jjiang193/salinityspoon/docs/dashboard-out-of-range.png

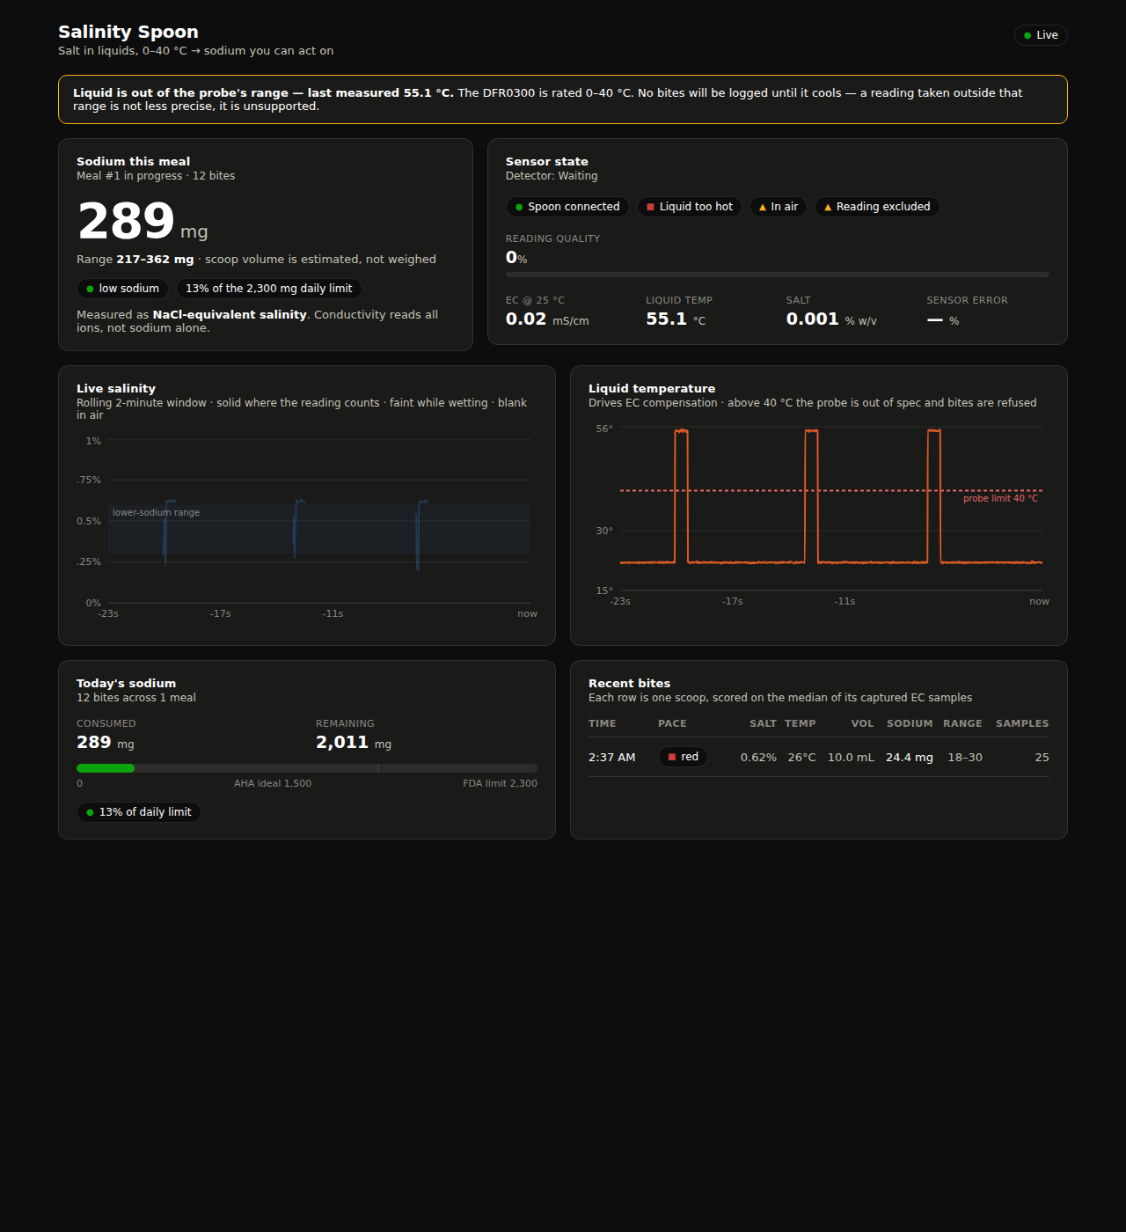
docs/dashboard-out-of-range.png
