jjiang193/salinityspoon/docs/dashboard.png

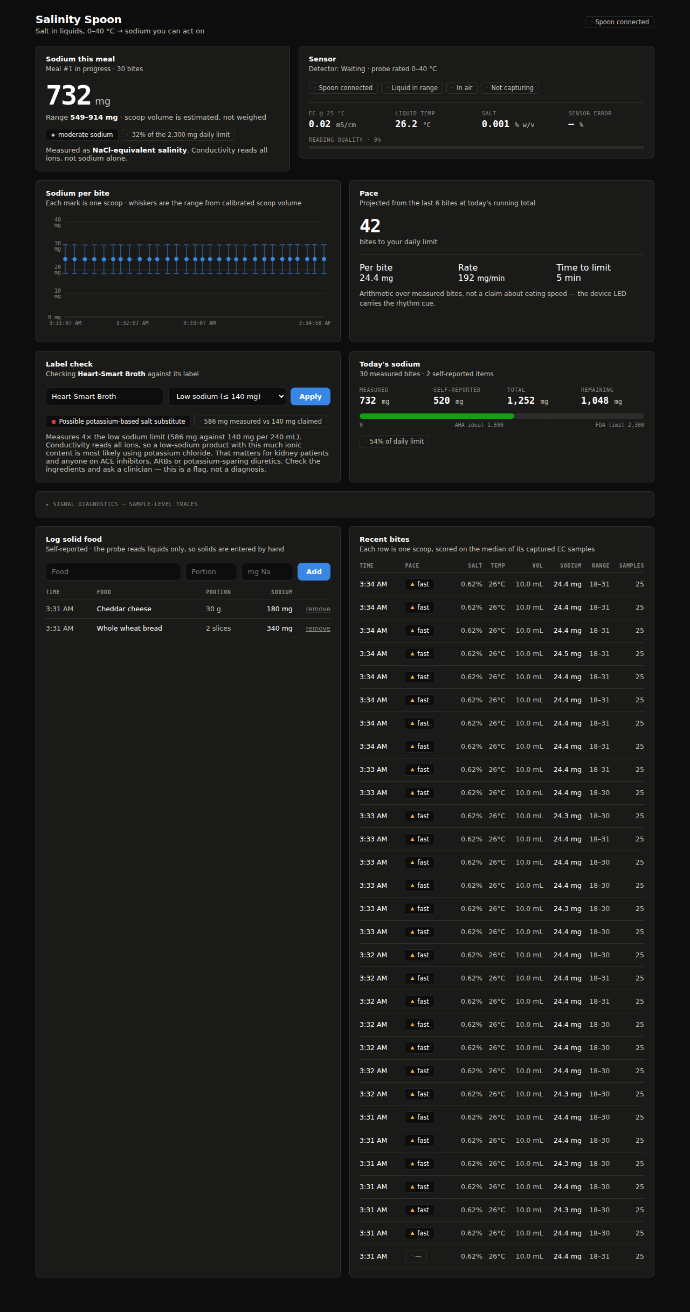
docs/dashboard.png
