jjiang193/salinityspoon/(commit log)

2026-09-19 Initial commit: salinity spoon, end to end against the simulator
    Measures salt in liquids between 0 and 40 C and reports per-bite sodium.
    Firmware, backend, dashboard and a protocol-accurate simulator.
    The DFR0300 probe is rated 0-40 C, so measuring soup at eating temperature
    (60-65 C) was never available: the library's 2%/degC compensation was never
    characterised out there, making such a reading unsupported rather than merely
    imprecise. Rather than hide that, the system is framed around liquids that are
    natively in range and enforces the limit as a hard interlock on both the device
    and the server. Above 40 C the firmware refuses to log a bite, the LED signals
    wait, and the backend rejects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
2026-09-19 Add label checking, manual entry, and record/replay
    Four additions, aimed at the gaps a judge would find first.
    Potassium-substitute flag (backend/app/labels.py). The probe cannot separate
    sodium from potassium - it reads all ions. Normally a limitation, but salt
    substitutes are potassium chloride, so a product LABELLED low-sodium that
    MEASURES high ionic content is probably substituting. That matters for kidney
    patients and anyone on ACE inhibitors, ARBs or potassium-sparing diuretics, and
    no food database or barcode lookup can detect it. Declaring a label claim checks
    every subsequent bite against FDA per-serving limits (21 CFR 101.61). The flag
    only fires at 2x the claim, well outside th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
2026-09-19 Add host-side firmware tests, and fix a bite-rejection bug they found
    The firmware had never been compiled or run. The ESP32 toolchain is not
    reachable from this environment (egress policy blocks the arduino-cli release
    and downloads.arduino.cc), but the parts that can actually be wrong - the bite
    state machine and the salinity maths - are plain C++. firmware/test/ supplies a
    minimal Arduino shim with a controllable clock and exercises them natively with
    g++. 113 checks, no hardware required:
    make -C firmware/test
    The tests found a real bug. The stability gate used a standard deviation, which
    is itself not outlier-robust, so a single bubble among fifty good samples pushed
    it from ~0 to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
    [bite_detector.h, config.h]
2026-09-19 Redesign the dashboard: severity hierarchy, per-bite chart, sodium projection
    Three structural changes, in a bench-instrument idiom.
    SEVERITY HIERARCHY. The dashboard drew sixteen coloured chips from eight
    independent status systems, all sharing one green/amber/red palette. The
    consequence was visible: the temperature interlock - the most consequential
    state in the product - rendered identically to "the spoon is currently in air".
    When everything is coloured, nothing reads as urgent.
    src/lib/severity.ts now decides tier centrally. Ambient state (connected, in
    air, not capturing, under the daily limit) is neutral; advisory is a muted
    marker; only attention states get colour - disconnection,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
2026-09-19 Add load-cell firmware as an alternative design, with bite simulation
    Adds firmware/loadcell/, an ESP32 sketch that weighs each bite with an HX711
    load cell instead of assuming a fixed scoop volume. It sits beside
    firmware/spoon/ for comparison and changes nothing in the existing design.
    - SalinityTest/: sensors at 50 Hz (non-blocking), bite detection, sodium per
    bite, red pace LED on GPIO25 (two bites < 6 s apart -> on for 5 s)
    - Bite rule: food leaves the spoon (weight < 30% of the scoop), then the EC
    probe says where it went: out of the food = eaten; still in liquid = dipped
    back into the soup; tipped past 70 deg = poured. Weight is only trusted near
    level; partial bites still co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
    [BiteDetector.cpp, BiteDetector.h, ECCalibrate.ino, ECCalibration.cpp, ECCalibration.h, LoadCellCalibrate.ino, PaceLed.cpp]
2026-09-19 Add HANDOFF.md for picking the project up cold
    Context for a fresh session or a teammate who has not read the thread: current
    state, how to run everything without hardware, the constraints that must not be
    quietly relaxed, the decisions already argued through with their reasons, and
    the next steps in order.
    The three things it leads with, because they are what a cold reader would
    otherwise get wrong: no hardware has ever been connected; the probe's 0-40 C
    rating is enforced twice on purpose and is not a flag-and-continue case; and
    every number the dashboard shows is wrong until the EC-to-NaCl curve is
    calibrated against the actual probe.
    Also records why this sandbox cannot compile the fir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
2026-09-19 Add NaTrack system design doc (PDF)
    The system design this firmware follows: four sensors fused on the device
    (EC via ADS1115, load cell via HX711, DS18B20, MPU-6050), sodium = weight x
    salinity computed on the spoon, a red pace LED driven locally, and one bite
    event per bite sent over MQTT to AWS IoT Core (queue -> Lambda -> DynamoDB),
    plus the clinician/patient REST API, live WebSocket session and frontend.
    It disagrees with PLAN.md on the load cell, AWS and the pace LED, the same
    points this PR raises, so it's included here for the team to compare.
2026-09-19 Clinician dashboard, patient portal and live view, on NaTrack's API
    Reframes the dashboard as a tool for healthcare providers, as NaTrack's three
    views, and moves every consumer onto bite/v2.
    Clinician: a roster of patients, each against their own sodium target, most
    pressing first, one status chip per row. A patient's chart has a week/month
    trend of measured vs self-reported sodium, MealSummary rows that open onto
    their bites, NaTrack's pace metrics, the health log, and the target editor.
    Patient portal: start and end a meal (declaring the product up front, so the
    label is checked from the first bite), log food, log blood pressure and weight,
    a month of history. Live: whoever holds the spo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
2026-09-20 Trust layer, patient Today, sodium sources and vitals on one day axis
    Answer the user's decision instead of displaying the instrument, and never
    show a stale or false number as if it were true. Everything here is
    arithmetic over rows that already existed: no new tables, no SCHEMA_VERSION
    bump, no requirements change, firmware untouched.
    Backend
    - Return what was stored and dropped at the API boundary: meal mean salinity
    and mg per 240 mL, the full label check (severity, ratio, headline, detail),
    per-day and today low/high ranges (sum of per-bite ranges), a per-product
    `sources` breakdown on /summary, `sample_age_s` on /api/spoon.
    - The live label check judges the open meal's weight-av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
2026-09-20 firmware: rebuild the measurement flow around a dipped probe
    The probe is now a separate instrument dipped into the spoon, not a sensor
    riding in the bowl. Four states, one per physical step:
    EMPTY -> LOADED -> DIPPING -> MEASURED -> EMPTY(bite)
    The rule that shapes everything: the load cell is only believable while the
    probe is out. Weight is measured and latched in LOADED, frozen through
    DIPPING, and believed again in MEASURED.
    All false-bite logic is gone. A falling weight ends the bite, full stop - no
    pour detection, no "was the probe still in liquid", no abort. POUR_TILT_DEG,
    IMMERSED_FRACTION and DROP_START_FRACTION are deleted. Tipping a measured
    spoonful back into the bowl is re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
2026-09-20 firmware: set LOADCELL_SCALE from hardware calibration
    Measured on the real load-cell spoon with LoadCellCalibrate and a 32 g
    known weight: 16950.12 counts per gram. Weight now reads in grams
    instead of raw HX711 counts, which the gram thresholds in BiteDetector
    (MIN_SCOOP_G, EMPTY_FRACTION) depend on.
    Also clears the "[WARN] LOADCELL_SCALE not set" startup message in
    Sensors.cpp, which fires while the value is still 1.0f.
2026-09-20 AWS phase 1: the bite ingest spine as SAM
    IoT Core -> topic rule -> SQS -> ingestBite Lambda -> DynamoDB, per
    docs/natrack-system-design.pdf and docs/loadcell/aws-handoff.md. Nothing
    publishes to it yet: the firmware has no MQTT client, and the local backend
    keeps serving the demo, as HANDOFF.md intends.
    The Lambda is the cloud twin of backend/app/main.py:_handle_bite and enforces
    the same contract (docs/telemetry-schema.md):
    - 0-40 C is refused, not flagged - a third place enforcing the interlock
    - schema, types, probe ceiling, load-cell range and clock skew are checked
    - the patient comes from the device pairing, never from the payload
    - writes are guarded by attribute_not_exists(SK) on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
2026-09-20 infra: make the test script wait for the write, and allow a true replay
    Two flaws found by running it against the deployed stack:
    - it slept a flat 8 s, which a cold start (~0.5 s init behind a 5 s batching
    window) beat, so a stored bite looked missing. It now polls the count for up
    to 30 s and prints the count before publishing.
    - passing the same bite_id was not a replay: the script minted a fresh
    timestamp each run, and the timestamp is part of the dedupe key, so two
    genuine bites were stored - correctly. A replay is the same payload, so the
    timestamp is now an optional third argument.
    Verified end to end: a new bite logs stored=True, republishing the identical
    payload logs st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
2026-09-20 firmware: latch the weight, latch the dip, and require a pour
    Rebuilt around what the bench actually does: fill the bowl, wait, dip the two
    probes, lift them out, tip it out. Five states, three latches:
    EMPTY -> FILLING -> LOADED -> DIPPING -> MEASURED -> EMPTY (bite)
    - the weight latches after LOAD_SETTLE_MS (3 s) of steady weight, so pouring
    food in is never mistaken for the food being there
    - the salinity latches when the dip ends: lifting the probes out cannot change
    it, only a new dip can
    - a bite needs the weight gone for EMPTY_HOLD_MS (2 s) AND the bowl tipped past
    POUR_TILT_DEG (45 deg) while it emptied
    The tilt requirement is the substantive change. Weight leaving a level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
    [BiteDetector.cpp, BiteDetector.h, Net.cpp, Net.h, Salinity.h, SalinityTest.ino]
2026-09-20 infra: the spoon publishes now, and one of its bites is in the table
    The README said the firmware had no MQTT client and that nothing published
    except the test script. Both were true when phase 1 was written and neither is
    now: #9 adds Wi-Fi, NTP and MQTT/TLS, and a real bite from the board has landed
    in natrack-telemetry.
    Records what one looks like on arrival, including pour_tilt_deg - a firmware
    extension the contract did not name when this stack was written. Nothing in the
    Lambda changes: unknown keys are stored and unknown flags tolerated, which is
    the point of keeping every raw field.
2026-09-20 AWS phase 2: the live session, as a WebSocket per patient
    ingestBite now pushes each stored bite to anyone watching that patient, over an
    API Gateway WebSocket API. NaTrack's live view and the demo both run on this.
    The push is best effort and comes after the write, in that order on purpose:
    the table is the source of truth, so a bite nobody was watching is not a bite
    that was lost. A failed push is logged and dropped rather than retried - the
    bite is already durable and a retry would only delay the next one - and a
    replayed bite is never pushed twice, because the conditional write is what
    decides whether anything is new.
    Connections are rows with a TTL, two per socket:
    SESSION#<patient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
    [template.yaml]
2026-09-20 infra: stop batching the queue, and the live view lands in a second
    Deployed phase 2 and measured it: 22 s from publish to the watcher's screen.
    The socket was never the problem - MaximumBatchingWindowInSeconds was 5, so the
    Lambda's poller sat on each bite before invoking, and a cold start followed.
    At 0 the same test lands in under a second (published 07:59:52, on screen
    07:59:53). The window is pure latency on a live view, and one spoon sends a
    bite every few seconds at most; batching is worth having at 10k bites/s, which
    is the scaled design point, not the demo.
    [template.yaml]
2026-09-20 AWS phase 3: NaTrack's /v1 endpoints, behind Cognito
    An HTTP API with a Cognito JWT authorizer in front of a query Lambda: the
    roster, a patient's summary, raw bites, the sodium target, the health log and
    device pairing. Two groups, patient and clinician, as the design specifies.
    canAccess is the whole security story and it is one function every route calls.
    A patient's own id comes from their token, never from the request. A clinician
    needs an assignment row, checked on every call. Tested against the deployed
    stack: no token 401, patient reading themselves 200, patient reading another
    patient 404 - the same answer as a patient who does not exist, because
    confirming which ids are real is it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
2026-09-20 dashboard: the sign-in card used variables this project does not have
    --panel, --line, --bg, --muted and --accent-ink were invented; the real names
    are --surface, --border, --plane, --text-muted and --on-accent. The card
    rendered with no background, no border and muted text that resolved to
    nothing, which is what a white screen looks like from the outside.
    Also, both by request:
    - the demo accounts are patient@natrack-demo.com and
    clinician@natrack-demo.com. They were .invalid, which RFC 2606 reserves so a
    demo address can never reach a real mailbox; nothing is sent to these either
    (Cognito's mail is suppressed), so the domain is a house-style choice and the
    rule that matters is un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
    [template.yaml]
2026-09-20 dashboard, api: what the clinician view needs, and what a patient should see
    Three separate faults behind one report.
    The clinician screen was white because the roster calls .toFixed on
    pct_of_target_today and pct_of_target_avg, and the API did not send either -
    an undefined there is a TypeError, and a TypeError in render is a blank page.
    The summary now returns the whole PatientSummary shape the dashboard's own
    types declare: the two percentages, upward_drift, pace_flagged_meals,
    last_activity_at, clinicianId and enrolled_at. DailyTotal's bite_count and
    manual_count were camelCase too, so the day rows were counted as zero bites.
    "Server unreachable" came from polling /api/spoon, which onl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
2026-09-20 api: port the /api endpoints the patient portal runs on
    The portal reported the server unreachable because five endpoints it needs
    only existed on the laptop: today's intake, who holds the spoon, the claim
    list, meals, and self-reported food. It was right - nothing was answering.
    Ported: GET /api/intake/today, /api/spoon, /api/label-claims, /api/meals,
    /api/manual-meals, POST /api/manual-meals, DELETE /api/manual-meals/{id}. Each
    goes through the same require_access as the /v1 routes, so a patient still
    cannot read another patient's food log.
    Two judgements worth recording:
    /api/spoon's sample_age_s is the age of the last BITE, not of the last sample.
    Raw samples never leave the device on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
2026-09-20 README: the project as it now is, including how to see it running
    The README described a system with no load cell, no cloud and no hardware
    bring-up, which stopped being true in the last two days. Rewritten around what
    exists:
    - the hosted dashboard's address and its two demo logins, in the open because
    both accounts hold invented patients and the file says so beside them
    - two spoons, one contract: the volume-calibrated spoon that speaks WebSocket
    to a laptop, and the load-cell spoon that weighs a bite and publishes MQTT to
    AWS. Neither is "the" spoon; the contract is what lets them compete
    - the local demo path kept first and kept intact - no accounts, no internet,
    because a venue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
2026-09-20 live: send the open meal's totals with each bite, and say why the traces are empty
    Two things the first real cloud demo showed.
    "Sodium this meal" stayed at a dash because the local backend's session message
    carries meal_totals and the cloud's did not. The ingest now derives the open
    meal's running totals the same way query/app.py derives meals - walk back from
    the newest bite while the gaps stay inside the 20-minute rule - and sends them
    with the push. One query per bite over the last hour, which at one bite every
    few seconds is nothing. Verified on a live socket: biteCount 3, totalSodium
    51.3 mg, avgBiteIntervalSec 3.8.
    The sample-level charts said "waiting for samples" for ever, which r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
2026-09-20 live: a "Last bite" panel for cloud builds, instead of an empty sensor card
    SensorStatus reports live samples and withdraws them the moment the spoon goes
    quiet, because a frozen "Capturing - 14.2 mS/cm" is indistinguishable from a
    working spoon. That rule is right, and no sample ever reaches the cloud, so on
    the hosted dashboard the card could only ever say "No spoon seen yet" over a
    table of bites it had just measured.
    Rather than dress a bite up as live telemetry, cloud builds get a panel that
    says what it is: the last bite, when it was taken, and how long ago. Same
    readouts - EC, liquid temperature, salt, sensor error - plus the weight, the
    EC sample count behind the number and the qual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
